MrFezaro/Concept_Prometheus/docs/assets/1.png

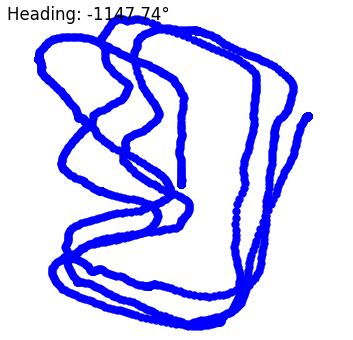
docs/assets/1.png
