MrFezaro/Concept_Prometheus/docs/assets/2.png

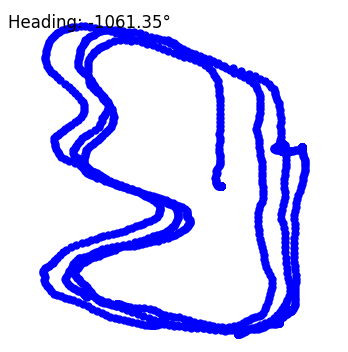
docs/assets/2.png
