MrFezaro/Concept_Prometheus/docs/assets/4.png

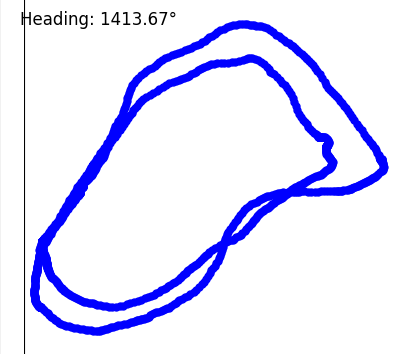
docs/assets/4.png
