MrFezaro/Concept_Prometheus/docs/assets/track.png

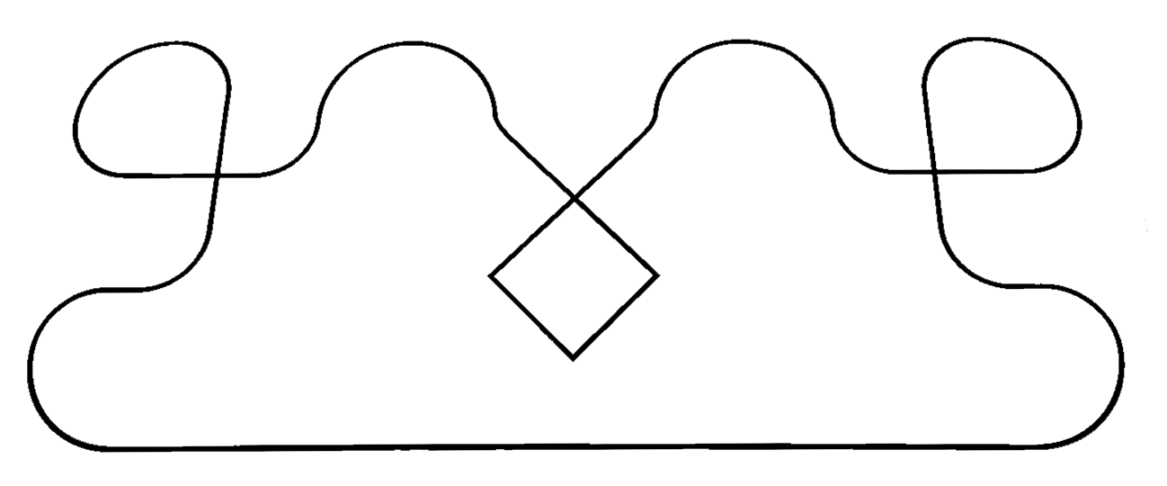
docs/assets/track.png
