MrFezaro/Concept_Prometheus/docs/assets/v0.jpg

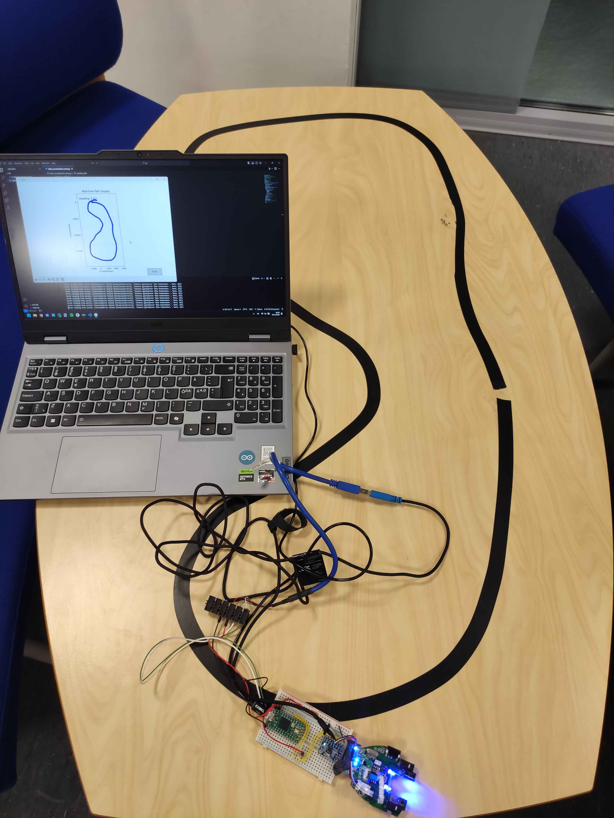
docs/assets/v0.jpg
