MrFezaro/Concept_Prometheus/test/README

## These examples shows how:
 * Bluetooth can be implemented when using the Arduino Nano 33 IoT to change the parameters
 * The optical flow sensor test setup works
 * Visualization of the map works
