MrFezaro/Concept_Prometheus/(commit log)

2024-11-04 Added PID controller
2024-11-09 Added motor encoder logic
2024-11-11 Added cad model gif and circuit diagram
2024-11-15 Added missing setup initializers
    [main.cpp]
2024-11-15 Added more cad pics in README.md
